chatelao/aity-xmas-2026/kicad/aity-xmas-tree-2026.kicad_pcb

## KiCad design kicad/aity-xmas-tree-2026.kicad_pcb (2026-10-19)

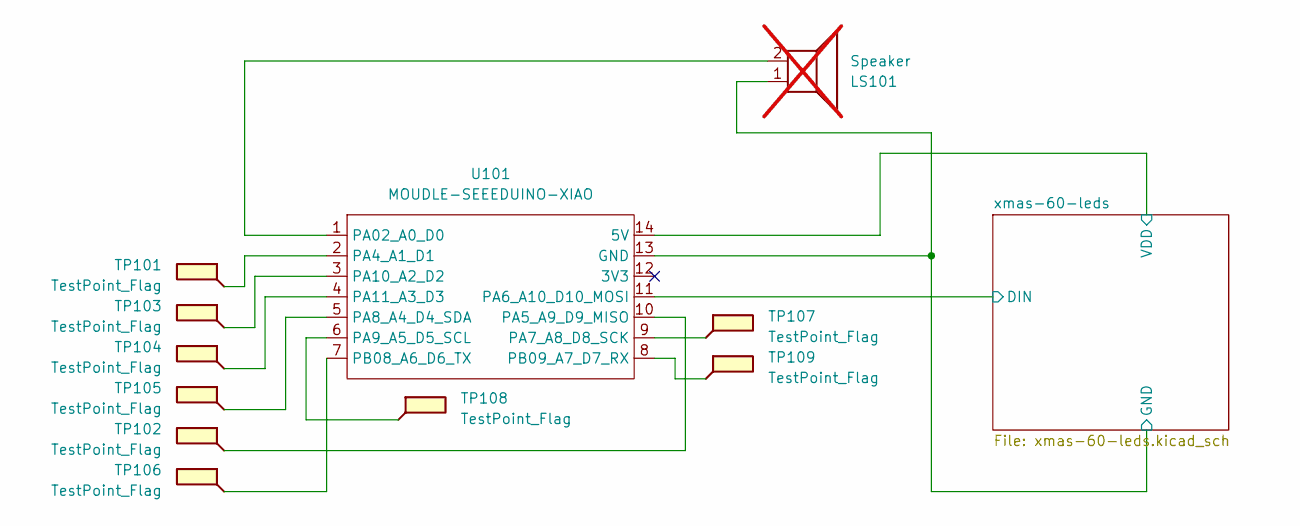
[picture p1: schematic aity-xmas-tree-2026.kicad_sch]

Parts:
LS101: Speaker; MagneticBuzzer_CUI_CMT-8504-100-SMT; not fitted
TP101, TP102, TP103, TP104, TP105, TP106, TP107, TP108, TP109: TestPoint_Flag; Kugel
U101: MOUDLE-SEEEDUINO-XIAO; MCU_Seeed_ESP32C3

Connections:
/xmas-60-leds/DIN: U101.11 (PA6_A10_D10_MOSI); also elsewhere on the board
/xmas-60-leds/GND: LS101.1, U101.13 (GND); also elsewhere on the board
/xmas-60-leds/VDD: U101.14 (5V); also elsewhere on the board
unnamed: LS101.2, U101.1 (PA02_A0_D0)
unnamed: TP101.1, U101.2 (PA4_A1_D1)
unnamed: TP102.1, U101.10 (PA5_A9_D9_MISO)
unnamed: TP107.1, U101.9 (PA7_A8_D8_SCK)
unnamed: TP105.1, U101.5 (PA8_A4_D4_SDA)
unnamed: TP108.1, U101.6 (PA9_A5_D5_SCL)
unnamed: TP103.1, U101.3 (PA10_A2_D2)
unnamed: TP104.1, U101.4 (PA11_A3_D3)
unnamed: TP106.1, U101.7 (PB08_A6_D6_TX)
unnamed: TP109.1, U101.8 (PB09_A7_D7_RX)

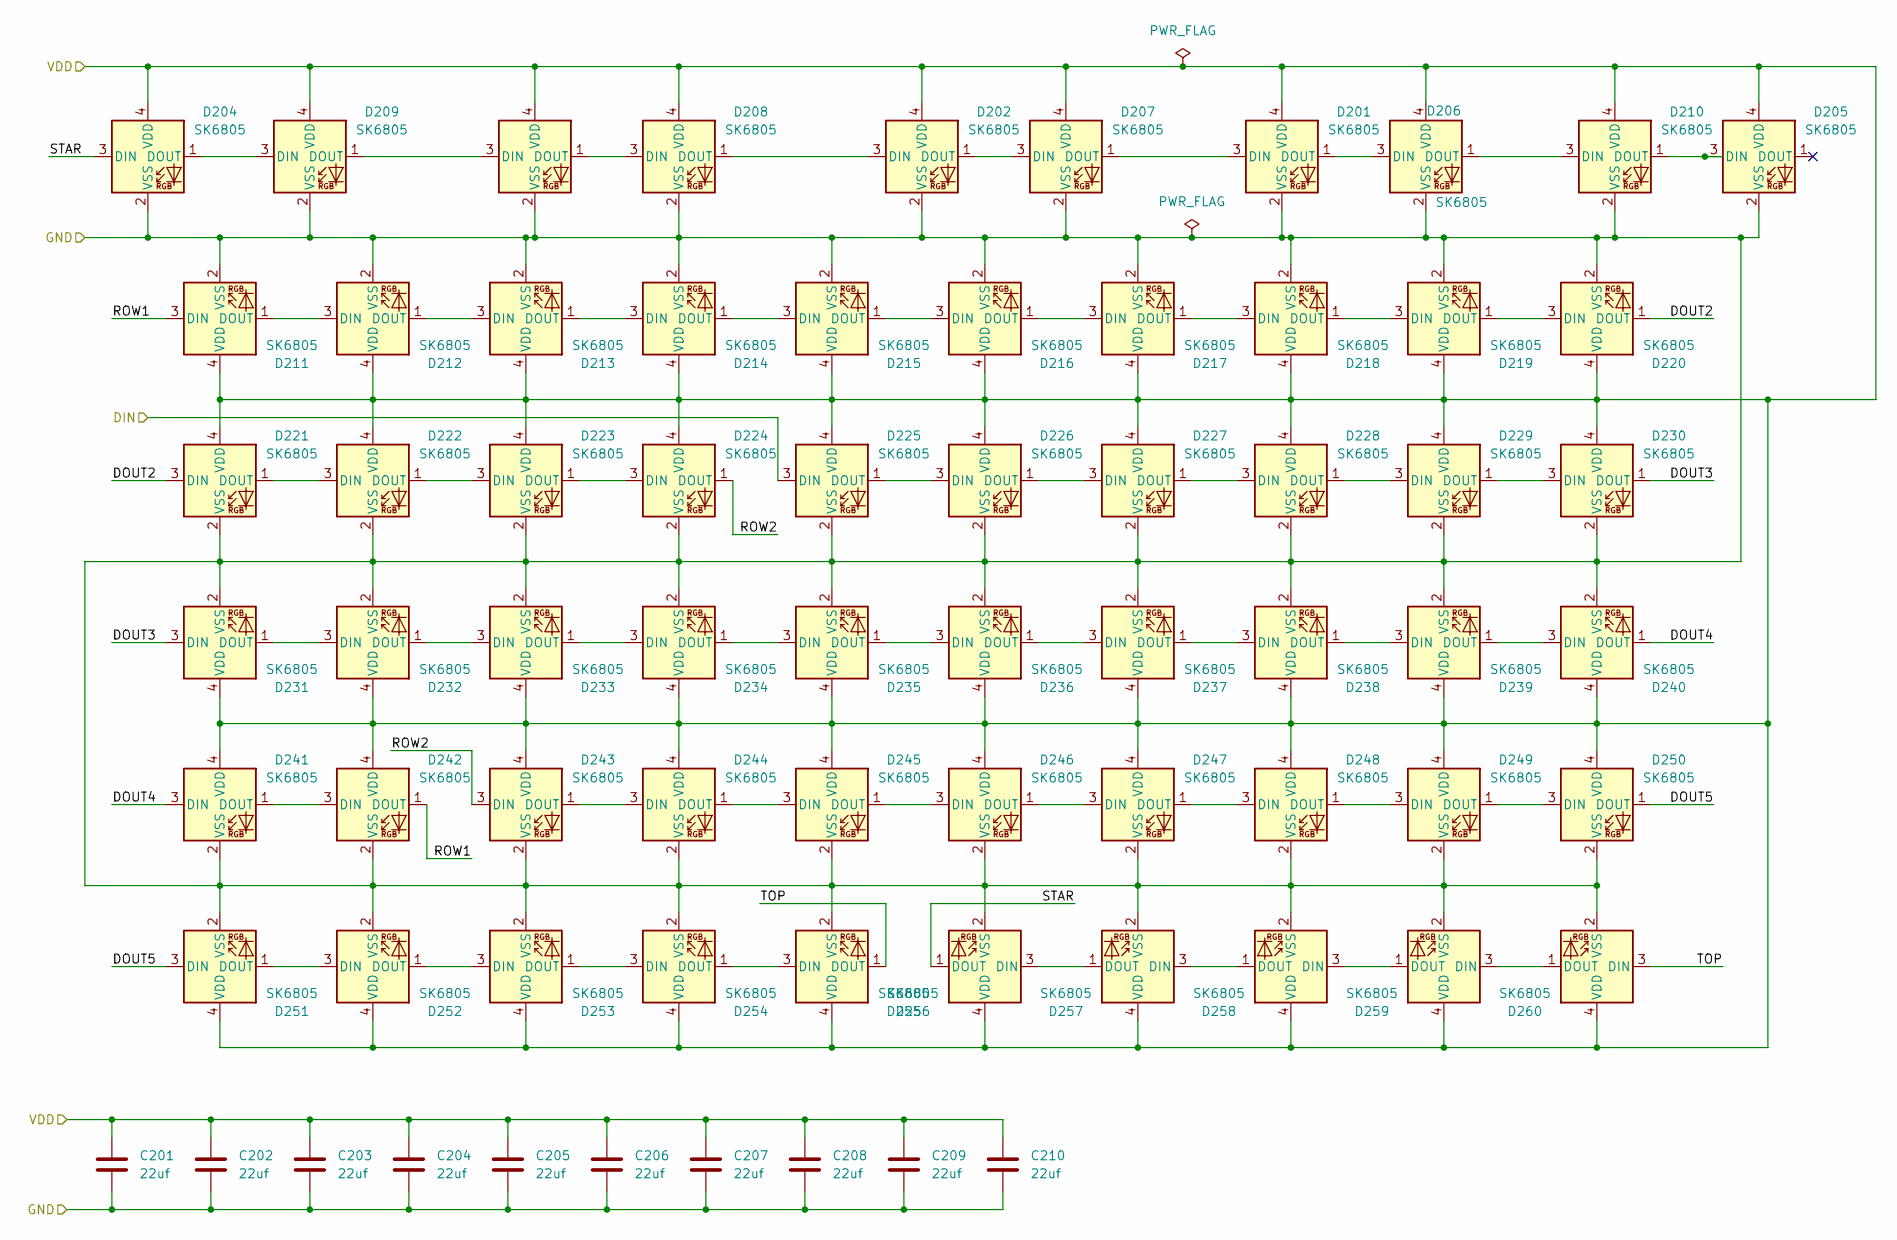
[picture p2: schematic xmas-60-leds.kicad_sch]

Parts:
C201, C202, C203, C204, C205, C206, C207, C208, C209, C210: 22uf; C_0603_1608Metric
D201, D203, D204, D205, D207, D208, D209, D210, D211, D212, D213, D214, D215, D216, D217, D218, D219, D220, D221, D222, D223, D224, D225, D226, D227, D228, D229, D230, D231, D232, D233, D234, D235, D236, D237, D238, D239, D240, D241, D242, D243, D244, D245, D246, D247, D248, D249, D250, D251, D252, D253, D254, D255, D256, D257, D258, D259, D260: SK6805; LED_SK6812_1.5x1.5mm
D202, D206: SK6805; LED_SK6805_PLCC4_2.4x2.7mm_P1.3mm

Connections:
/xmas-60-leds/DIN: D225.3 (DIN); also elsewhere on the board
/xmas-60-leds/DOUT2: D220.1 (DOUT), D221.3 (DIN)
/xmas-60-leds/DOUT3: D230.1 (DOUT), D231.3 (DIN)
/xmas-60-leds/DOUT4: D240.1 (DOUT), D241.3 (DIN)
/xmas-60-leds/DOUT5: D250.1 (DOUT), D251.3 (DIN)
/xmas-60-leds/GND: C201.2, C202.2, C203.2, C204.2, C205.2, C206.2, C207.2, C208.2, C209.2, C210.2, D201.2 (VSS), D202.2 (VSS), D203.2 (VSS), D204.2 (VSS), D205.2 (VSS), D206.2 (VSS), D207.2 (VSS), D208.2 (VSS), D209.2 (VSS), D210.2 (VSS), D211.2 (VSS), D212.2 (VSS), D213.2 (VSS), D214.2 (VSS), D215.2 (VSS), D216.2 (VSS), D217.2 (VSS), D218.2 (VSS), D219.2 (VSS), D220.2 (VSS), D221.2 (VSS), D222.2 (VSS), D223.2 (VSS), D224.2 (VSS), D225.2 (VSS), D226.2 (VSS), D227.2 (VSS), D228.2 (VSS), D229.2 (VSS), D230.2 (VSS), D231.2 (VSS), D232.2 (VSS), D233.2 (VSS), D234.2 (VSS), D235.2 (VSS), D236.2 (VSS), D237.2 (VSS), D238.2 (VSS), D239.2 (VSS), D240.2 (VSS), D241.2 (VSS), D242.2 (VSS), D243.2 (VSS), D244.2 (VSS), D245.2 (VSS), D246.2 (VSS), D247.2 (VSS), D248.2 (VSS), D249.2 (VSS), D250.2 (VSS), D251.2 (VSS), D252.2 (VSS), D253.2 (VSS), D254.2 (VSS), D255.2 (VSS), D256.2 (VSS), D257.2 (VSS), D258.2 (VSS), D259.2 (VSS), D260.2 (VSS); also elsewhere on the board
/xmas-60-leds/ROW1: D211.3 (DIN), D242.1 (DOUT)
/xmas-60-leds/ROW2: D224.1 (DOUT), D243.3 (DIN)
/xmas-60-leds/STAR: D204.3 (DIN), D256.1 (DOUT)
/xmas-60-leds/TOP: D255.1 (DOUT), D260.3 (DIN)
/xmas-60-leds/VDD: C201.1, C202.1, C203.1, C204.1, C205.1, C206.1, C207.1, C208.1, C209.1, C210.1, D201.4 (VDD), D202.4 (VDD), D203.4 (VDD), D204.4 (VDD), D205.4 (VDD), D206.4 (VDD), D207.4 (VDD), D208.4 (VDD), D209.4 (VDD), D210.4 (VDD), D211.4 (VDD), D212.4 (VDD), D213.4 (VDD), D214.4 (VDD), D215.4 (VDD), D216.4 (VDD), D217.4 (VDD), D218.4 (VDD), D219.4 (VDD), D220.4 (VDD), D221.4 (VDD), D222.4 (VDD), D223.4 (VDD), D224.4 (VDD), D225.4 (VDD), D226.4 (VDD), D227.4 (VDD), D228.4 (VDD), D229.4 (VDD), D230.4 (VDD), D231.4 (VDD), D232.4 (VDD), D233.4 (VDD), D234.4 (VDD), D235.4 (VDD), D236.4 (VDD), D237.4 (VDD), D238.4 (VDD), D239.4 (VDD), D240.4 (VDD), D241.4 (VDD), D242.4 (VDD), D243.4 (VDD), D244.4 (VDD), D245.4 (VDD), D246.4 (VDD), D247.4 (VDD), D248.4 (VDD), D249.4 (VDD), D250.4 (VDD), D251.4 (VDD), D252.4 (VDD), D253.4 (VDD), D254.4 (VDD), D255.4 (VDD), D256.4 (VDD), D257.4 (VDD), D258.4 (VDD), D259.4 (VDD), D260.4 (VDD); also elsewhere on the board
unnamed: D201.3 (DIN), D207.1 (DOUT)
unnamed: D201.1 (DOUT), D206.3 (DIN)
unnamed: D202.3 (DIN), D208.1 (DOUT)
unnamed: D202.1 (DOUT), D207.3 (DIN)
unnamed: D203.3 (DIN), D209.1 (DOUT)
unnamed: D203.1 (DOUT), D208.3 (DIN)
unnamed: D204.1 (DOUT), D209.3 (DIN)
unnamed: D205.3 (DIN), D210.1 (DOUT)
unnamed: D206.1 (DOUT), D210.3 (DIN)
unnamed: D211.1 (DOUT), D212.3 (DIN)
unnamed: D212.1 (DOUT), D213.3 (DIN)
unnamed: D213.1 (DOUT), D214.3 (DIN)
unnamed: D214.1 (DOUT), D215.3 (DIN)
unnamed: D215.1 (DOUT), D216.3 (DIN)
unnamed: D216.1 (DOUT), D217.3 (DIN)
unnamed: D217.1 (DOUT), D218.3 (DIN)
unnamed: D218.1 (DOUT), D219.3 (DIN)
unnamed: D219.1 (DOUT), D220.3 (DIN)
unnamed: D221.1 (DOUT), D222.3 (DIN)
unnamed: D222.1 (DOUT), D223.3 (DIN)
unnamed: D223.1 (DOUT), D224.3 (DIN)
unnamed: D225.1 (DOUT), D226.3 (DIN)
unnamed: D226.1 (DOUT), D227.3 (DIN)
unnamed: D227.1 (DOUT), D228.3 (DIN)
unnamed: D228.1 (DOUT), D229.3 (DIN)
unnamed: D229.1 (DOUT), D230.3 (DIN)
unnamed: D231.1 (DOUT), D232.3 (DIN)
unnamed: D232.1 (DOUT), D233.3 (DIN)
unnamed: D233.1 (DOUT), D234.3 (DIN)
unnamed: D234.1 (DOUT), D235.3 (DIN)
unnamed: D235.1 (DOUT), D236.3 (DIN)
unnamed: D236.1 (DOUT), D237.3 (DIN)
unnamed: D237.1 (DOUT), D238.3 (DIN)
unnamed: D238.1 (DOUT), D239.3 (DIN)
unnamed: D239.1 (DOUT), D240.3 (DIN)
unnamed: D241.1 (DOUT), D242.3 (DIN)
unnamed: D243.1 (DOUT), D244.3 (DIN)
unnamed: D244.1 (DOUT), D245.3 (DIN)
unnamed: D245.1 (DOUT), D246.3 (DIN)
unnamed: D246.1 (DOUT), D247.3 (DIN)
unnamed: D247.1 (DOUT), D248.3 (DIN)
unnamed: D248.1 (DOUT), D249.3 (DIN)
unnamed: D249.1 (DOUT), D250.3 (DIN)
unnamed: D251.1 (DOUT), D252.3 (DIN)
unnamed: D252.1 (DOUT), D253.3 (DIN)
unnamed: D253.1 (DOUT), D254.3 (DIN)
unnamed: D254.1 (DOUT), D255.3 (DIN)
unnamed: D256.3 (DIN), D257.1 (DOUT)
unnamed: D257.3 (DIN), D258.1 (DOUT)
unnamed: D258.3 (DIN), D259.1 (DOUT)
unnamed: D259.3 (DIN), D260.1 (DOUT)

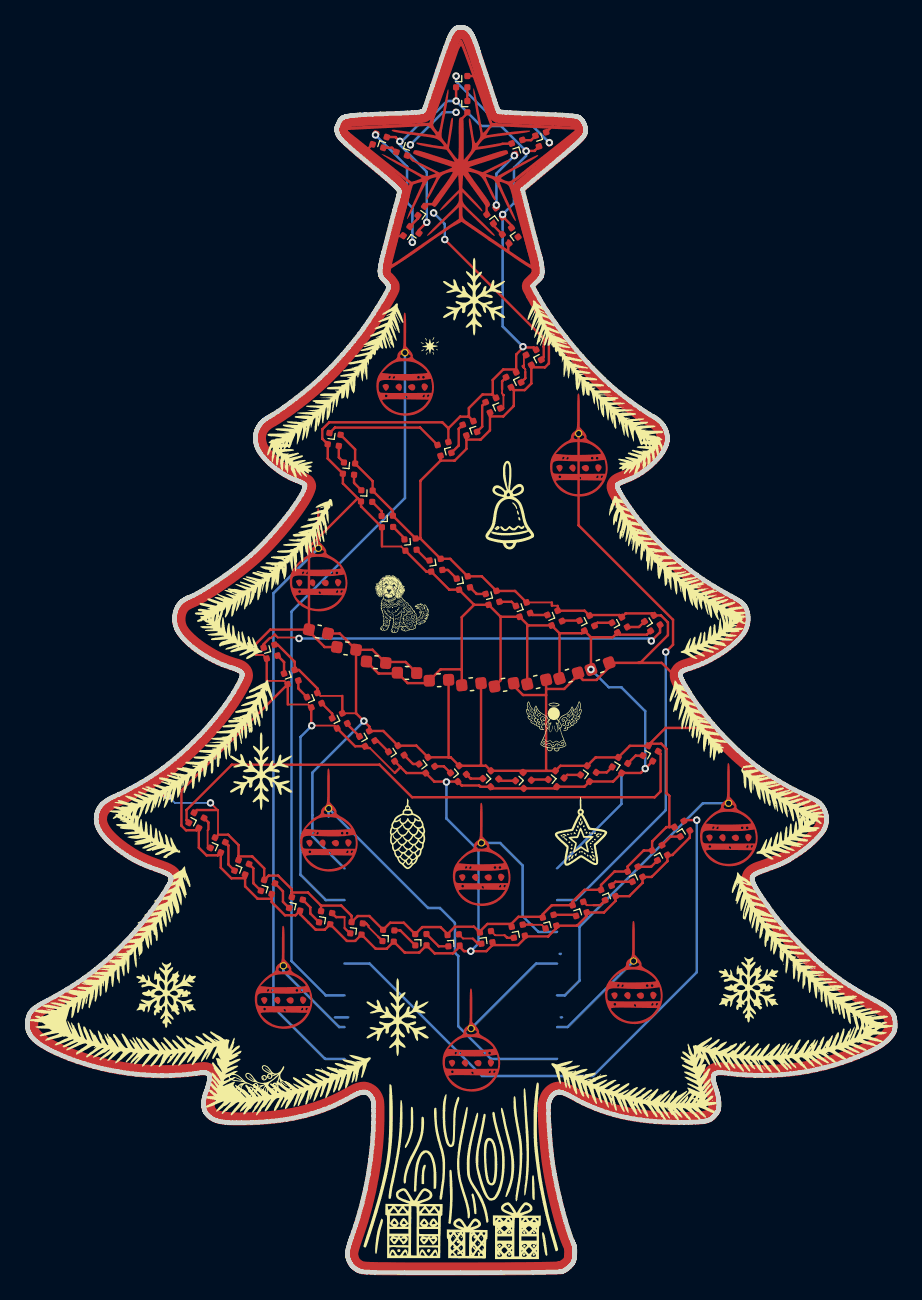
[picture p3: board aity-xmas-tree-2026.kicad_pcb from above]

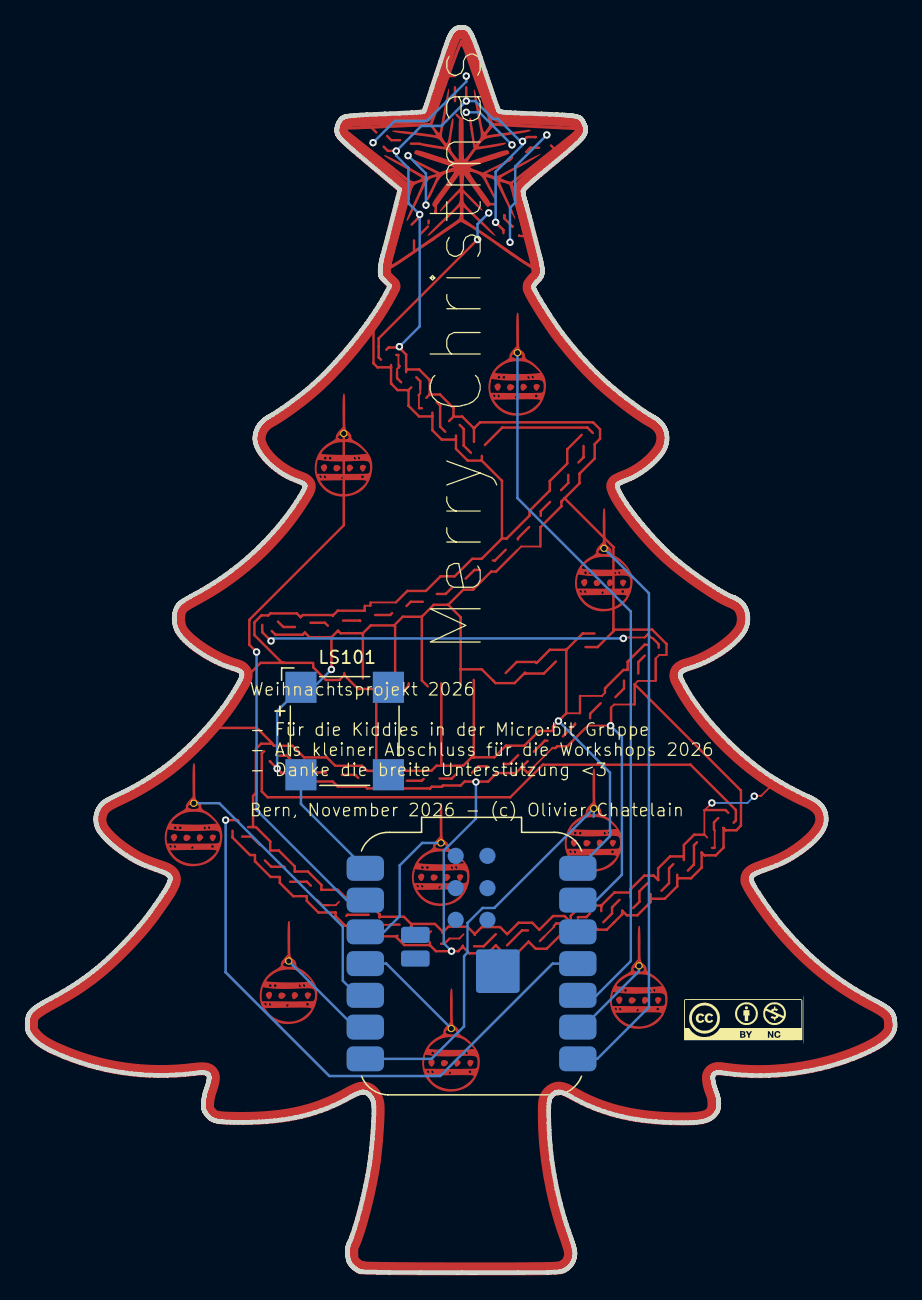
[picture p4: board aity-xmas-tree-2026.kicad_pcb from below]

Board: 2 copper layers, 69.4 x 99.6 mm, 81 parts (2 on the bottom side), 72 nets.
