chatelao/aity-xmas-2026/(commit log)

2026-10-19 Create kibot.yaml configuration file
    Added configuration for kibot with various filters, variants, and output options.
2026-10-19 Add KiCad DRC and ERC checks workflow
    This workflow file sets up KiCad DRC and ERC checks on push and pull request events. It includes steps for triggering a dispatch, finding KiCad projects, running checks, and uploading artifacts.
2026-10-19 Update KiCad project paths in workflow file
2026-10-19 docs: Add ASCII pinout diagram and CircuitPython rainbow script to README
    - Add project summary and hardware specs for AITY Xmas Tree 2026.
    - Add detailed ASCII pinout diagram for Seeed Studio XIAO ESP32-C6.
    - Add pin mapping table for all pins (D10 NeoPixels, D0 Speaker, D1-D9 TestPoints).
    - Add example CircuitPython script with rainbow animation on 60 NeoPixel LEDs.
2026-10-19 docs: Add ASCII pinout and CircuitPython rainbow script; fix CI schema paths
    - Update README.md with hardware specs, ASCII pinout diagram, pin mapping table, and example CircuitPython rainbow animation script.
    - Update .github/workflows/kicad-checks.yml to pass correct file paths in the kicad/ directory to KiBot.
2026-10-19 fix: remove non-existent inner layers from kibot config
    [kibot.yaml]
2026-10-26 Add CI/CD workflow to compile Arduino examples to UF2 for XIAO RP2040 and XIAO ESP32-C6
2026-11-09 Add NeoPixel initialization and pin scanner
    This script initializes a NeoPixel strip and scans candidate pins on the XIAO RP2040 to detect grounded connections, updating the LED indicators accordingly.
2026-11-10 docs: support RP2040 and ESP32-C6 with HOWTO guides
